Gabriel0GGR/NMM-Project/Others/Capacitor - CADCAM Mechanical 1.TXT

G04 PROTEUS RS274X GERBER FILE*
%FSLAX24Y24*%
%MOIN*%
%ADD12C,0.0080*%
G54D12*
X-7500Y-7500D02*
X+7500Y-7500D01*
X+7500Y+7500D01*
X-7500Y+7500D01*
X-7500Y-7500D01*
M00*
