Gabriel0GGR/NMM-Project/Presentation/Flowchart.pdf

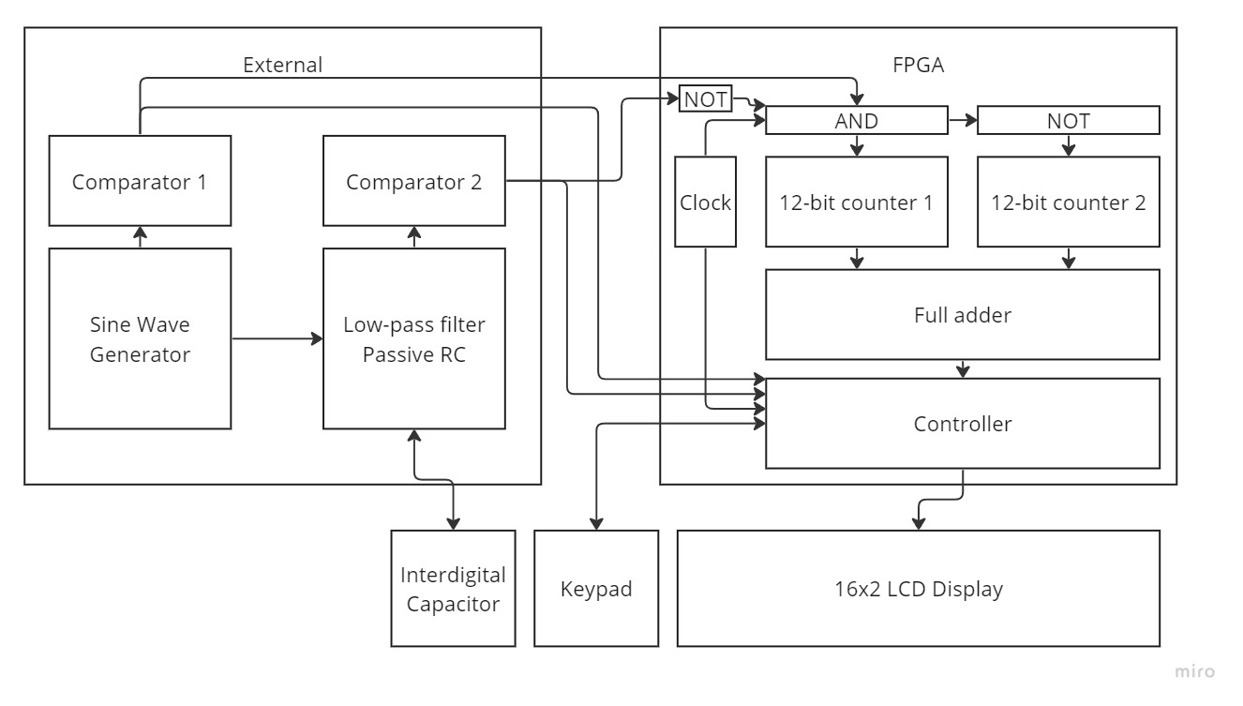
[picture p13: page 1]
