Gabriel0GGR/NMM-Project/Presentation/Non-contact Moisture Meter (NMM).png

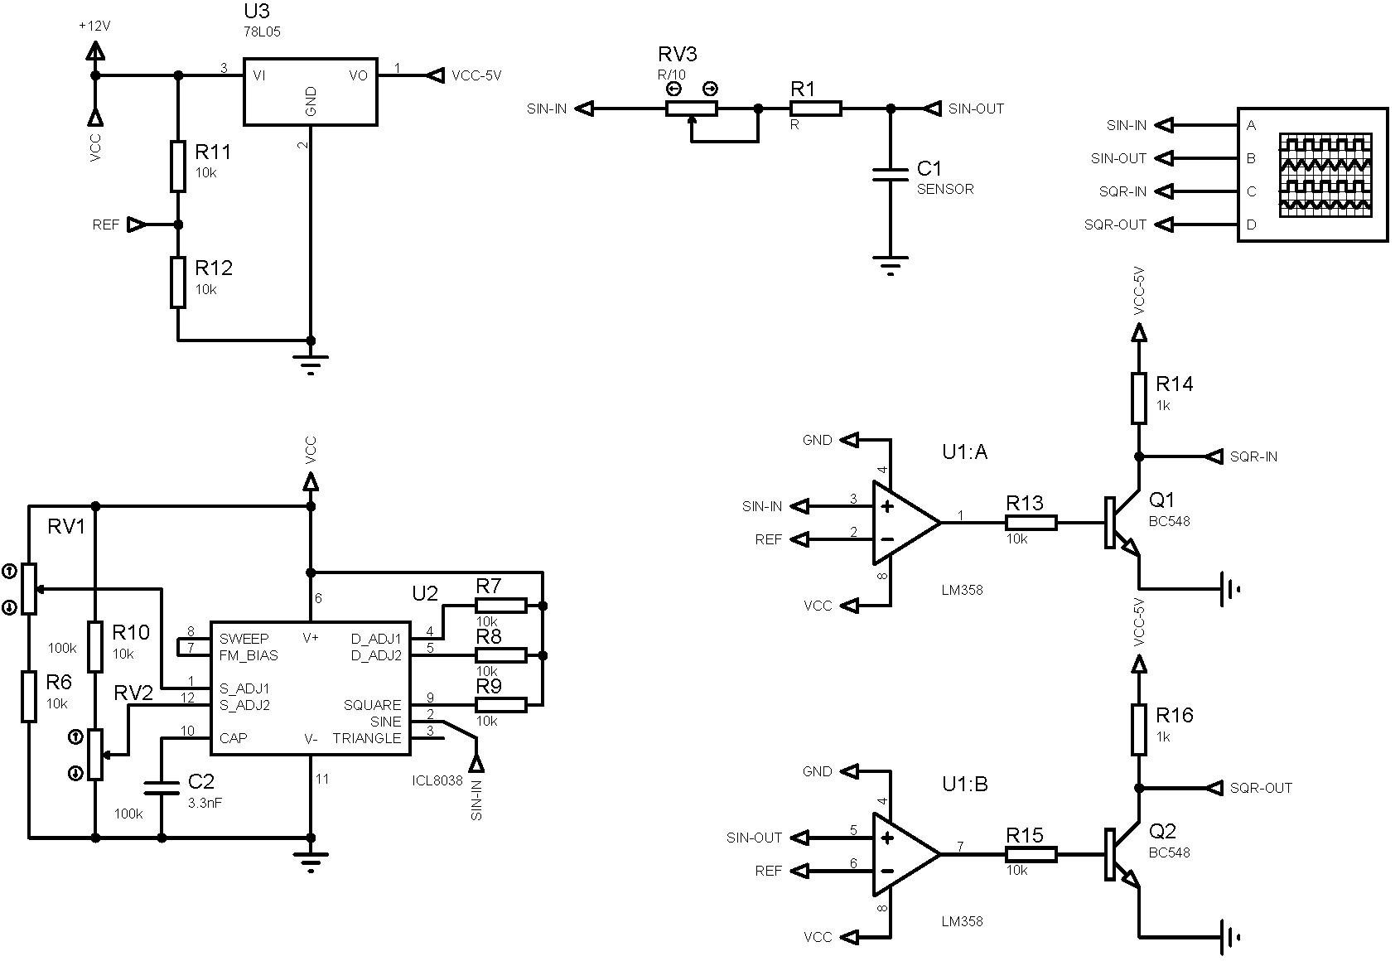
Presentation/Non-contact Moisture Meter (NMM).png
