Gabriel0GGR/NMM-Project/(list of files, cad)

Other CAD files:
CLK_MULTIPLIER/simulation/qsim/work/clk_multiplier/verilog.psm
CLK_MULTIPLIER/simulation/qsim/work/clk_multiplier_vlg_check_tst/verilog.psm
CLK_MULTIPLIER/simulation/qsim/work/clk_multiplier_vlg_sample_tst/verilog.psm
CLK_MULTIPLIER/simulation/qsim/work/clk_multiplier_vlg_vec_tst/verilog.psm
Controller/simulation/qsim/work/controller/structure.psm
Controller/simulation/qsim/work/controller_vhd_vec_tst/controller_arch.psm
NMM - Copy/simulation/qsim/work/hard_block/verilog.psm
NMM - Copy/simulation/qsim/work/nmm/verilog.psm
NMM - Copy/simulation/qsim/work/nmm_vlg_check_tst/verilog.psm
NMM - Copy/simulation/qsim/work/nmm_vlg_sample_tst/verilog.psm
NMM - Copy/simulation/qsim/work/nmm_vlg_vec_tst/verilog.psm
NMM - Cópia/simulation/qsim/work/hard_block/verilog.psm
NMM - Cópia/simulation/qsim/work/nmm_vlg_check_tst/verilog.psm
NMM - Cópia/simulation/qsim/work/nmm_vlg_sample_tst/verilog.psm
NMM - Cópia/simulation/qsim/work/nmm_vlg_vec_tst/verilog.psm
NMM/simulation/qsim/work/hard_block/verilog.psm
NMM/simulation/qsim/work/nmm_vlg_check_tst/verilog.psm
NMM/simulation/qsim/work/nmm_vlg_sample_tst/verilog.psm
NMM/simulation/qsim/work/nmm_vlg_vec_tst/verilog.psm
OLD/Controller - OLD/simulation/qsim/work/controller/verilog.psm
OLD/Controller - OLD/simulation/qsim/work/controller_vlg_check_tst/verilog.psm
OLD/Controller - OLD/simulation/qsim/work/controller_vlg_sample_tst/verilog.psm
OLD/Controller - OLD/simulation/qsim/work/controller_vlg_vec_tst/verilog.psm
OLD/Controller/simulation/qsim/work/controller/verilog.psm
OLD/Controller/simulation/qsim/work/controller_vlg_check_tst/verilog.psm
OLD/Controller/simulation/qsim/work/controller_vlg_sample_tst/verilog.psm
OLD/Controller/simulation/qsim/work/controller_vlg_vec_tst/verilog.psm
OLD/Decoder2_4/simulation/qsim/work/decoder2_4/verilog.psm
OLD/Decoder2_4/simulation/qsim/work/decoder2_4_vlg_check_tst/verilog.psm
OLD/Decoder2_4/simulation/qsim/work/decoder2_4_vlg_sample_tst/verilog.psm
OLD/Decoder2_4/simulation/qsim/work/decoder2_4_vlg_vec_tst/verilog.psm
OLD/NMM - Cópia - Cópia/simulation/qsim/work/nmm/verilog.psm
OLD/NMM - Cópia - Cópia/simulation/qsim/work/nmm_vlg_check_tst/verilog.psm
OLD/NMM - Cópia - Cópia/simulation/qsim/work/nmm_vlg_sample_tst/verilog.psm
OLD/NMM - Cópia - Cópia/simulation/qsim/work/nmm_vlg_vec_tst/verilog.psm
OLD/NMM - Cópia/simulation/qsim/work/nmm/verilog.psm
OLD/NMM - Cópia/simulation/qsim/work/nmm_vlg_check_tst/verilog.psm
OLD/NMM - Cópia/simulation/qsim/work/nmm_vlg_sample_tst/verilog.psm
OLD/NMM - Cópia/simulation/qsim/work/nmm_vlg_vec_tst/verilog.psm
OLD/NMM/simulation/qsim/work/nmm/verilog.psm
OLD/NMM/simulation/qsim/work/nmm_vlg_check_tst/verilog.psm
OLD/NMM/simulation/qsim/work/nmm_vlg_sample_tst/verilog.psm
OLD/NMM/simulation/qsim/work/nmm_vlg_vec_tst/verilog.psm
OLD/NMM_first/simulation/qsim/work/@n@m@m/verilog.psm
OLD/NMM_first/simulation/qsim/work/@n@m@m_vlg_check_tst/verilog.psm
OLD/NMM_first/simulation/qsim/work/@n@m@m_vlg_sample_tst/verilog.psm
OLD/NMM_first/simulation/qsim/work/@n@m@m_vlg_vec_tst/verilog.psm
OLD/NMM_first/simulation/qsim/work/nmm/verilog.psm
OLD/NMM_first/simulation/qsim/work/nmm_vlg_check_tst/verilog.psm
OLD/NMM_first/simulation/qsim/work/nmm_vlg_sample_tst/verilog.psm
OLD/NMM_first/simulation/qsim/work/nmm_vlg_vec_tst/verilog.psm
Others/Average/simulation/qsim/work/average/structure.psm
Others/Average/simulation/qsim/work/average_vhd_vec_tst/average_arch.psm
Others/Average/simulation/qsim/work/hard_block/structure.psm
Others/Controller/simulation/qsim/work/controller/structure.psm
Others/Controller/simulation/qsim/work/controller_vhd_vec_tst/controller_arch.psm
Others/Controller/simulation/qsim/work/hard_block/structure.psm
