Gabriel0GGR/NMM-Project/Presentation/Non-contact Moisture Meter (NMM).pdf

C1

R1

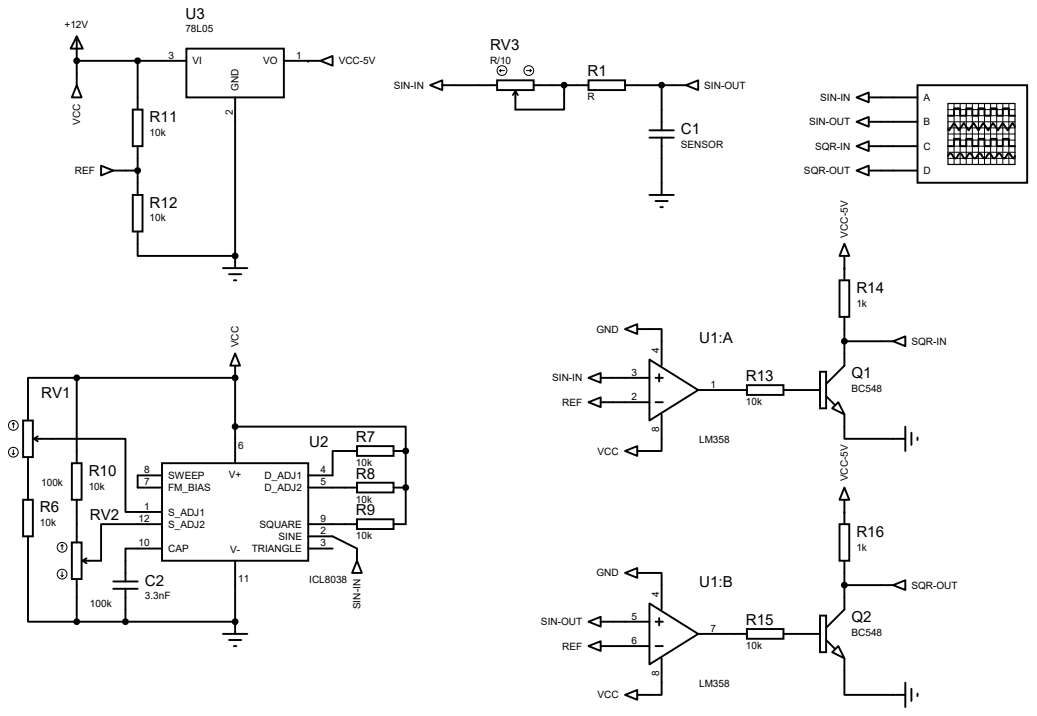
[picture p15: page 1]
