Gabriel0GGR/NMM-Project/(list of files, drawings)

Other design files:
Others/Capacitor.LYT
