Gabriel0GGR/NMM-Project/NMM - Cópia/simulation/qsim/work/nmm_vlg_sample_tst/_primary.vhd

library verilog;
use verilog.vl_types.all;
entity nmm_vlg_sample_tst is
    port(
        b0              : in     vl_logic;
        b1              : in     vl_logic;
        b2              : in     vl_logic;
        b3              : in     vl_logic;
        clk             : in     vl_logic;
        sqr_in          : in     vl_logic;
        sqr_out         : in     vl_logic;
        sampler_tx      : out    vl_logic
    );
end nmm_vlg_sample_tst;
